Integrated-Project-2-2025-UVic-UCC/Group-5/(commit log)

2025-03-25 Rough codes
    These are the codes that have been created so far.
    Base Code is still not functional and pending tests are required for the motor to work with the test code.
    Further testing will be made going forward.
2025-04-18 Base and Test Code Updates
    Base code now contains the new iteration of tested code, runs the motor and detects (and avoids) clogging via current sensor.
    Test code implements changes to the clogging system, making it more reliable. Also includes support for additional pins for paper and door detection for additional security.
    Electronic equipments must be aquired to test the mentioned implementations.
    Future additions will include support for servomotor control for mechanical de-clogging comb system
    [Base_Code.ino]
2025-04-22 Test Code updates and minor fixes
    Added support for Servomotors in the test code.
    Must decide when will servomotors be active for better use.
    Implementatios require hardware to be added to the project (capacitive sensor and limit stop sensor) but can be tested without.
    Electronics Leader must confirm addition of previously mentioned components.
